lch199912/TreadmillWidefield/README.md

# TreadmillWidefield

This repository includes following two components used in paper, "Widefield cortical activity and connectivity on the motorized locomotion"

1. Tutorial and designs for assembling custom treadmill and disk.
2. Codes for analysis widefield imaging data and behavior data.
