lch199912/TreadmillWidefield/Track Assembly/Treadmill/Treadmill Part List.xlsx

Number | Item Name | Specification | Needed Quantity | Vendor | Purchase Link | Notes
1 | 2060 Aluminum Profile | 2060 profile, 200mm length, anodized black | 1 | uxcell / Amazon | Link (https://www.amazon.com/gp/product/B0D1KDHMYC/ref=ox_sc_act_title_6?smid=A30WUG2ZDGM0XM&psc=1)
2 | 2020 Aluminum Profile | 2020 profile, 200mm length, anodized black | 2 | uxcell / Amazon | Link (https://www.amazon.com/gp/product/B0D1KC96Y8/ref=ox_sc_act_title_1?smid=A30WUG2ZDGM0XM&psc=1)
3 | Ball Bearing | F698ZZ, 8mm ID × 19mm OD × 6mm Width, Double Shielded, Chrome Steel | 4 | uxcell / Amazon | Link (https://www.amazon.com/gp/product/B07Z3G8B2X/ref=ox_sc_act_title_2?smid=A1THAZDOWP300U&th=1)
4 | Shaft Collar | 8mm ID, 14mm OD, Set Screw Locking, Black | 4 | uxcell / Amazon | Link (https://www.amazon.com/gp/product/B0CQ2PXBRF/ref=ewc_pr_img_1?smid=A30WUG2ZDGM0XM&psc=1)
5 | Shaft Coupler | 6mm to 8mm Bore, Rigid Type, L25mm × D14mm, with Set Screws | 1 | LULUQUEEN / Amazon | Link (https://www.amazon.com/Shaft-Coupler-Connector-Coupling-Printers/dp/B0CNQ4ZC6F)
6 | 2020 Corner Bracket | For 2020 Aluminum Profile, Black | 4 | orgry / Amazon | Link (https://www.amazon.com/Aluminum-Profile-Connector-Corner-Bracket/dp/B0B12G6P9L)
7 | 20 Series M5 T-Nut | M5 Thread, for 2020 Profile, Black | 22 | orgry / Amazon | Link (https://www.amazon.com/Aluminum-Profile-Connector-Corner-Bracket/dp/B0B12G6P9L)
8 | M5×8mm Hex Socket Cap Screw | M5 thread, 8mm length, Black | 22 | orgry / Amazon | Link
9 | 2020 Corner Bracket | For 2020 Aluminum Profile, for base frame fixation | 4
10 | 1/4 inch Socket Bolt | 1/4 inch, Hex Socket, Steel | 4
11 | GT2 Timing Pulley Set | 20T & 60T, 5mm Bore, with 200mm × 6mm Belt (GT2), Aluminum | 1 | Zeberoxyz / Amazon | Link (https://www.amazon.com/Zeberoxyz-Synchronous-Aluminum-Timing-20-60T-5B-6/dp/B08QYYF6W4)
12 | Stepper Motor | Bipolar, 1.8°/step (200 steps/rev), 42×38mm, 2.8V, 1.7 A/Phase | 1 | Pololu | Link (https://www.pololu.com/product/2267)
13 | Incremental Encoder | Omron E6B2-CWZ6C, 1024 P/R, NPN Open Collector, Solid Shaft (6mm), 2m Cable | 1 | Omron
14 | NEMA17 Motor Mount Bracket | L-Shape Steel Bracket for 42mm Stepper (NEMA17), Includes Screws and Nuts, Model: K-029-42 | 1 | weideer / Amazon | Link (https://www.amazon.com/weideer-Stepper-Mounting-Bracket-K-029-42/dp/B09372B2D1)
15 | Encoder Mounting Bracket |  | 1
16 | 14XL Timing Pulley | 14 Teeth, XL Profile, 8mm Bore, 58mm Length, No Flange | 2 | Custom Machining
17 | Custom Shaft 1 | 8mm diameter, D-cut, 82mm length (Set 1), made to custom spec | 1 | Custom Machining |  | See GitHub drawings for reference.
18 | Custom Shaft 2 | 8mm diameter, D-cut, 113mm length (Set 2), made to custom spec | 1 | Custom Machining |  | See GitHub drawings for reference.
19 | 204XL Timing Belt | 58mm width | 1 | Custom Machining
20 | Sidebar | 3D printed frame for fixing pulley on side of assembly | 4 | 3D Print |  | See GitHub drawings for reference.
21 | 2020 Profile Cover | 3D printed cover for exposed 2020 aluminum profile sections | 2 | 3D Print |  | See GitHub drawings for reference.
22 | 2060 Profile Cover | 3D printed cover for exposed 2060 aluminum profile sections | 2 | 3D Print |  | See GitHub drawings for reference.
23 | Optical Post (TR6) | Ø1/2", Stainless Steel, 6" Length, 8-32 Setscrew, 1/4"-20 Tap | 1 | Thorlabs | Link (https://www.thorlabs.com/thorproduct.cfm?partnumber=TR6-P5)
24 | Pedestal Post Holder (PH3E) | Ø1/2", Spring-Loaded Hex-Locking Thumbscrew, 3.19" Length | 1 | Thorlabs | Link (https://www.thorlabs.com/thorproduct.cfm?partnumber=PH3E)
25 | Pedestal Base Adapter (BE1) | Ø1.25", Studded Base, 1/4"-20 Threads | 1 | Thorlabs | Link (https://www.thorlabs.com/thorproduct.cfm?partnumber=BE1)
26 | Clamping Fork (CF038C) | For Ø1.25" Pedestal Bases, 0.40" Slot, 1/4"-20 Captive Screw | 1 | Thorlabs | Link (https://www.thorlabs.com/thorproduct.cfm?partnumber=CF038C-P5)
