lch199912/TreadmillWidefield/Track Assembly/Disk/Disk Part List.xlsx

Number | Item Name | Specification | Needed Quantity | Vendor | Purchase Link | Notes
1 | Acrylic Disk | 8 inch diameter acrylic disk. Painted with black spray. | 1 | Custom Machining |  | See GitHub drawings for reference.
2 | Aluminum Shaft 1 | 1/4″ (6.35 mm) diameter shaft, anodized 6061 aluminum, 7.5″ long
3 | Aluminum Shaft 2 | 1/4″ (6.35 mm) diameter shaft, anodized 6061 aluminum, 2″ long
4 | Mounting Hub | For 1/4″ (6.35 mm) shaft, aluminum, #4-40 threaded holes, 2-pack | 1 | Pololu | Link (https://www.pololu.com/product/1993)
5 | Stepper Motor | Bipolar, 1.8°/step (200 steps/rev), 42×38mm, 2.8V, 1.7 A/Phase | 1 | Pololu | Link
6 | Incremental Encoder | Omron E6B2-CWZ6C, 1024 P/R, NPN Open Collector, Solid Shaft (6mm), 2m Cable | 1 | Omron
7 | NEMA17 Motor Mount Bracket | L-Shape Steel Bracket for 42mm Stepper (NEMA17), Includes Screws and Nuts, Model: K-029-42 | 1 | weideer / Amazon | Link
8 | Encoder Mounting Bracket |  | 1
9 | 2020 Corner Bracket | For 2020 Aluminum Profile, for base frame fixation | 1
10 | Shaft Coupler 1 | Bore: 5mm to 6.35mm (1/4"), Size: L25×D14, Aluminum, Dark Blue | 1 | uxcell / Amazon | Link (https://www.amazon.com/gp/product/B08H87QDDQ/ref=ox_sc_act_title_1?smid=A1THAZDOWP300U&th=1)
11 | Shaft Coupler 2 | Bore: 6mm to 6.35mm (1/4"), Size: L25×D20, Aluminum | 1 | TA-VIGOR / Amazon | Link (https://www.amazon.com/gp/product/B0BWN7WPTJ/ref=ox_sc_act_title_1?smid=A1M89HU12DTHJ1&th=1)
12 | Bevel Gear | 1.5 Module, 20 Teeth, 6.35mm (1/4") bore, for 90° shaft coupling, M5 set screw | 2 | Xuulan / Amazon | Link (https://www.amazon.com/Xuulan-Bevel-Gears-Teeth-6-35mm-Module/dp/B0D17FC21R)
13 | Optical Post (TR4) | Ø1/2", Stainless Steel, 6" Length, 8-32 Setscrew, 1/4"-20 Tap | 1 | Thorlabs | Link (https://www.thorlabs.com/thorproduct.cfm?partnumber=TR4)
14 | Pedestal Post Holder (PH3E) | Ø1/2", Spring-Loaded Hex-Locking Thumbscrew, 3.19" Length | 1 | Thorlabs | Link (https://www.thorlabs.com/thorproduct.cfm?partnumber=PH3E)
15 | Pedestal Base Adapter (BE1) | Ø1.25", Studded Base, 1/4"-20 Threads | 1 | Thorlabs | Link (https://www.thorlabs.com/thorproduct.cfm?partnumber=BE1)
16 | Clamping Fork (CF038C) | For Ø1.25" Pedestal Bases, 0.40" Slot, 1/4"-20 Captive Screw | 1 | Thorlabs | Link (https://www.thorlabs.com/thorproduct.cfm?partnumber=CF038C-P5)
17 | M5 Nut | Metric M5, standard pitch | 1
18 | M5 Bolt | Metric M5, standard thread, length as required | 1
19 | 1/4 inch Bolt | 1/4″-20 UNC thread, standard head, length as required | 1
20
21
22
23
24
25
26
27
