lch199912/TreadmillWidefield/Track Assembly/Treadmill/Drawings/treadmill sidebar.stl

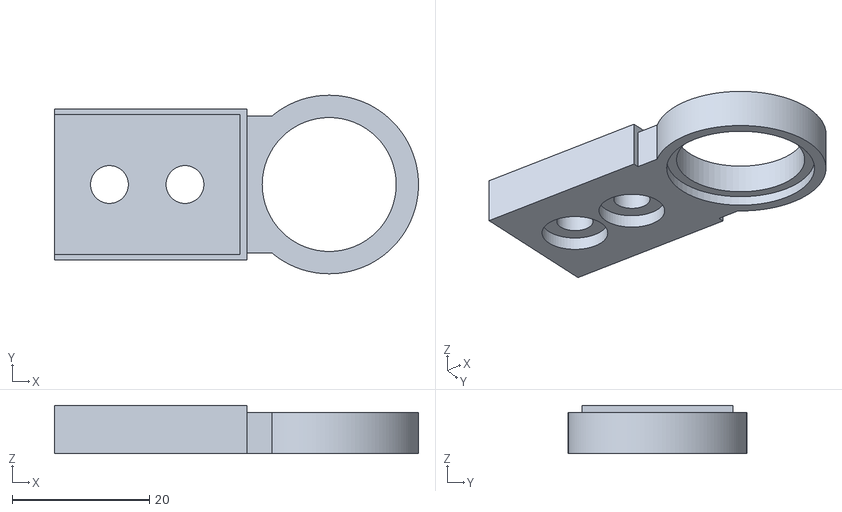
[picture p1: CAD file, 2025-05-03]
Track Assembly/Treadmill/Drawings/treadmill sidebar.stl
53.0 x 26.0 x 7.00
