lch199912/TreadmillWidefield/Track Assembly/Treadmill/Drawings/2060 profile cover.stl

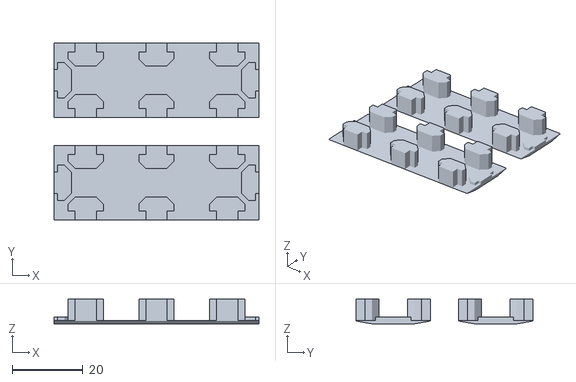
[picture p2: CAD file, 2025-05-03]
Track Assembly/Treadmill/Drawings/2060 profile cover.stl
58.0 x 50.0 x 7.00
