lch199912/TreadmillWidefield/Track Assembly/Treadmill/Drawings/2020 profile cover.stl

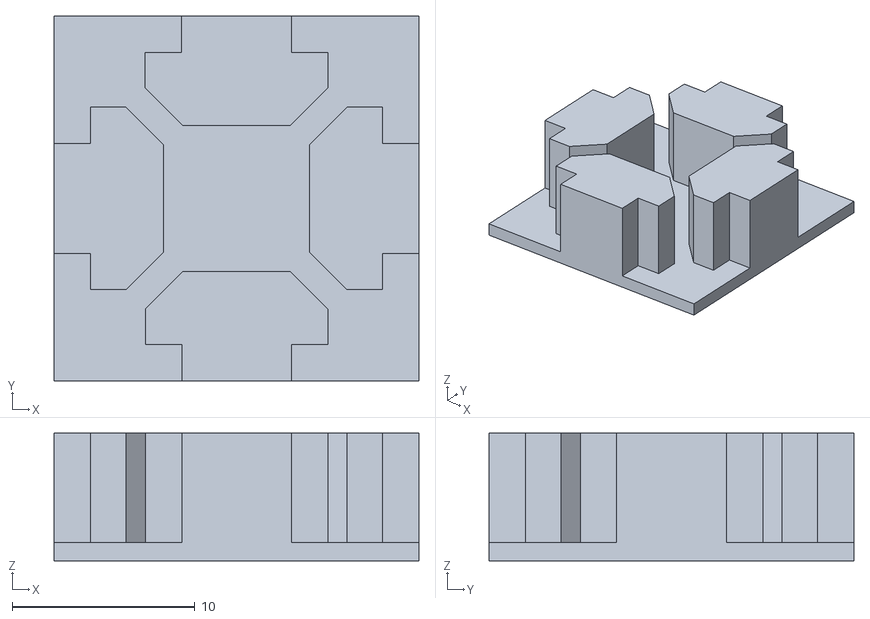
[picture p3: CAD file, 2025-05-03]
Track Assembly/Treadmill/Drawings/2020 profile cover.stl
20.0 x 20.0 x 7.00
