lch199912/TreadmillWidefield/(list of files, cad)

Other CAD files:
Track Assembly/Disk/disk plate.dwg
