lch199912/TreadmillWidefield/Track Assembly/Treadmill/Treadmill Assembly Guideline.pdf

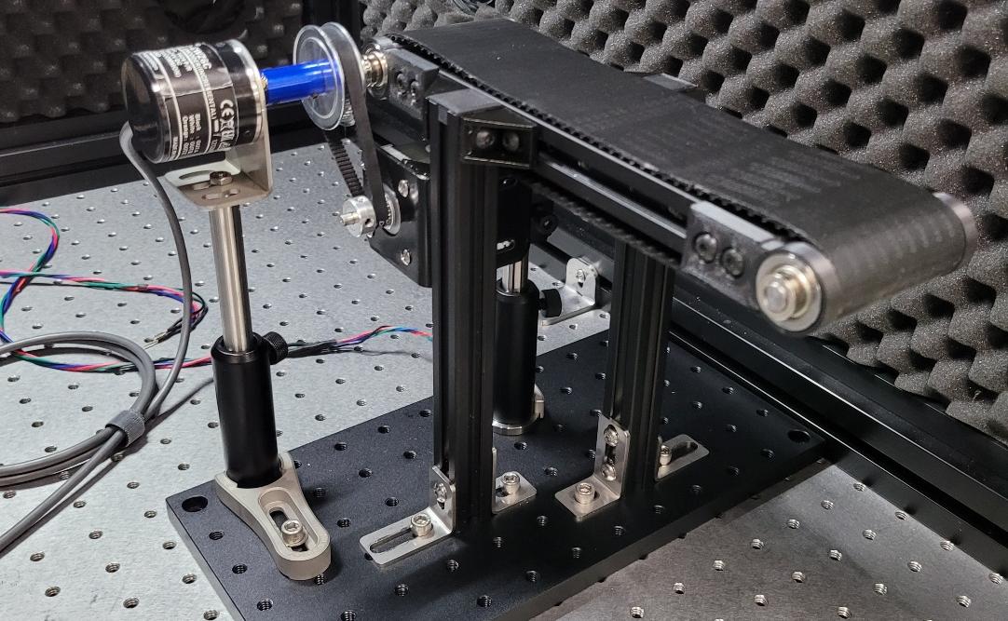
[picture p25: figure]
