lch199912/TreadmillWidefield/Track Assembly/Disk/README

# Custom Treadmill Assembly Documentation

This repository contains all necessary resources for assembling the custom disk, including:

- CAD drawings and schematics for custom parts
- Assembly instructions and notes
- 3D printed part files (STL)

## Available Documentation
- **Drawings**: CAD drawings for custom parts
- **Parts List**: Parts list for assembly available as a GitHub document
- **Assembly Guide**: Step-by-step assembly instructions available as a GitHub document

## Overview
The disk design incorporates custom-designed parts, standard mechanical components.  
It is intended for precise and stable operation.

### Important Notes
- Custom parts (Acrylic Plate) require reference to the provided technical drawings for correct fabrication.
- Ensure all components are assembled according to the provided guide to maintain structural integrity and mechanical alignment.

## License
This project is released for research and educational purposes. Please cite or credit appropriately when adapting or building upon this design.
